Lambosaurus/KicadLib/README.md

Kicad Libraries

# Installation
1. Open the dialog `Preferences -> Add Paths`
2. Add the key `LAMBO_LIB` with the library path, ie: `C:\dev\Kicad`
3. Import symbols using `Preferences -> Manage symbol libraries`
    - It is reccommended to add `sym-lib-table` as a Table library.
4. Import footprints using `Preferences -> Manage footprint libraries`
    - It is reccommended to add `fp-lib-table` as a Table library.
