Lambosaurus/KicadLib/(list of files, cad)

Other CAD files:
Step/module/myc-yt113x-v10_asm-0510.stp
Step/ant/AE_2450AT18A0100001E.step
Step/assembly/RAK3172.stp
Step/batt/Keystone-1043.step
Step/bga/BGA16_P0.35mm.step
Step/cap/CAP1210.step
Step/conn/amass/XT30PW(2+2).STEP
Step/conn/card/KP13B-SF-PEJ.step
Step/conn/dsub/DSUBB62-RA-F.step
Step/conn/hirose/DF40HC-40DS.stp
Step/conn/idc/IDC-Socket_2x25_P2.54mm_Horizontal.step
Step/conn/jst/JST_XH_S9B-XH-A_1x09_P2.50mm_Horizontal.step
Step/conn/push-in/MillMax_9401-0-15-15-23-27-10-0.STEP
Step/conn/rectangular/PIN_SMD_1.27_2x16.step
Step/conn/rj45/RJHSE-5080-04.step
Step/conn/SIM8051-6-0-14-00.STEP
Step/conn/usb/UCB_C_USB4145-03-0070-C.stp
Step/dfn/WSON6_3x3_HDC1080DMBR.stp
Step/diode/SOD882.step
Step/fet/PowerDI3333-8.step
Step/flt/balun_2450BM14G0011.stp
Step/fuse/FUSE0805.step
Step/ind/L_12x12mm_H8mm.step
Step/led/DS_SMD1313.step
Step/lga/LGA6_04_1.1x0.7.stp
Step/mech/BusBar_22x2.5mm.step
Step/mic/IM70D122V01XTMA1.stp
Step/module/Wio-SX1262.step
Step/msop/VSSOP10_05_3x3.step
Step/ntc/NTC0402.step
Step/pem/PEM_M2_4mm.step
Step/pqfn/PQFN8_5x6.step
Step/qfn/QFN40_05_6x6.stp
Step/qfp/LQFP-44_10x10mm_P0.8mm.step
Step/relay/SPDT_ALQ_FormC.step
Step/res/RES_Shunt_0612.step
Step/sensor/BME280.step
Step/so/SOP-4-6.5.step
Step/soic/SOIC-14_3.9x8.7mm_P1.27mm.step
Step/sot/SOT-553.step
Step/sot23/SOT23-8.step
Step/switch/ALPS_SPVS320200.step
Step/switch/limit/SW_XKB_DM1-16UP-1.step
Step/testpoint/5002.STEP
Step/to/TOLL-8.step
Step/transducer/Murata_PKMCS0909E4000-R1.step
Step/transformer/S024-12.2x17.6.STEP
Step/tssop/TSSOP-24.stp
Step/xtal/RV-3028-C7_32.768KHZ_1PPM-TA-QC.step
Step/ant/YC0009AA.stp
Step/assembly/XIAO_ESP32S3_Plus.step
Step/batt/BatteryHolder_Keystone_3034_1x20mm.step
Step/bga/WLCSP-6_1.46x1.1mm_Layout3x2_P0.4mm.step
Step/cap/CAP1206.step
Step/conn/dsub/DSUB09-RA-M.step
Step/conn/flat-flex/F3311A7H121008E200.step
Step/conn/hirose/DF40C-40DP.stp
Step/conn/idc/IDC-Header_2x25_P2.54mm_Vertical.step
Step/conn/jst/JST_XH_S10B-XH-A_1x10_P2.50mm_Horizontal.step
Step/conn/push-in/TBL-0019-350-02BE.step
Step/conn/rectangular/MTA_TH_2.54_1x6.stp
Step/conn/rj45/RJHSE-5381-04.step
Step/dfn/DFN8_5x6_127.step
Step/diode/DIO0603.step
Step/fet/DirectFET_ME.step
Step/fuse/FUSE1206.step
Step/ind/IHLP2525.step
Step/led/WS2812-2020.STEP
Step/lga/LGA-14_2.5x3.step
Step/mech/SMFLP12.0.stp
Step/module/ESP32-S3-WROOM-1U.STEP
Step/msop/VSSOP8_05_2.3x2.step
Step/ntc/NTC0603.step
Step/pem/PEM_M2_2.7mm_Wurth.stp
Step/qfn/QFN6_05_1x1_Skyworks.step
Step/qfp/LQFP-64_10x10mm_P0.5mm.step
Step/relay/AGQ200.step
Step/res/RES1225.STEP
Step/sensor/SHT40-AD1B-R2.STEP
Step/so/SOP-4-4.4.step
Step/soic/SOIC-16_3.9x9.9mm_P1.27mm.step
Step/sot/SOT-543.step
Step/sot23/SOT23-5.step
Step/switch/ESE-24MV1.stp
Step/switch/limit/SW_XKB_DM1-16UD-1.step
Step/testpoint/5000.STEP
Step/to/TO252.step
Step/transducer/InvenSense_ICS-40xxx_3.5x2.65mm.step
Step/transformer/SO16-7.11x12.7.STEP
Step/tssop/TSSOP-38.stp
Step/xtal/Crystal_SMD_2Pin_1.6x1.0mm.STEP
Step/assembly/U-BLOX_MAX-M10S-00B.STEP
Step/bga/WLP-4_0.83x0.83mm_P0.4mm.step
Step/cap/CAP1825.step
Step/conn/CON-SMA-EDGE-S.STEP
Step/conn/dsub/DSUB09-RA-F.step
Step/conn/flat-flex/F3311A7H121004E200.step
Step/conn/idc/IDC-Header_2x25_P2.54mm_Horizontal.step
Step/conn/jst/JST_XH_S6B-XH-A_1x06_P2.50mm_Horizontal.step
Step/conn/rectangular/MTA_TH_2.54_1x5.stp
Step/conn/rj45/RJMG1S8008101BR.stp
Step/conn/usb/USB_C_USB4105-GF-A-060.step
Step/dfn/DFN12_3x3_05.step
Step/diode/DIO0402.step
Step/fet/DirectFET_L8.step
Step/fuse/FUSE0603.step
Step/ind/IHLP2020.step
Step/led/LED1206_RVS.stp
Step/lga/LGA20_2.5X3.step
Step/mech/K3D-MM60-EZH039-B5-R2.STEP
Step/module/EG800Q-EU.step
Step/msop/MSOP8_065_3x3.step
Step/pem/PEM_M2_2mm.step
Step/qfn/QFN48_04_6x6.stp
Step/qfp/LQFP-48_7x7mm_P0.5mm.step
Step/relay/STST_NO_ALFG_FormA.step
Step/res/RES0612.STEP
Step/sensor/VL53L3CXV0DH_1.STEP
Step/soic/SOIC-8_3.9x4.9mm_P1.27mm.step
Step/sot/SOT-883.STEP
Step/sot23/SOT23-3.step
Step/switch/limit/SW_XKB_DM1-12UP-1.step
Step/switch/SW_SPST_SKQG_WithStem.step
Step/testpoint/5001.step
Step/transducer/SMT-0827-S-HT-R.step
Step/tssop/TSSOP-48.stp
Step/xtal/Crystal_SMD_2Pin_2.0x1.2mm.STEP
Step/assembly/XIAO_nRF54L15_Sense.step
Step/cap/CAP2220.step
Step/conn/flat-flex/F3311A7H121030E200.step
Step/conn/idc/IDC-Header_2x05_P2.54mm_Vertical.step
Step/conn/jst/JST_XH_S7B-XH-A_1x07_P2.50mm_Horizontal.step
Step/conn/keystone_1017-1.step
Step/conn/rectangular/MTA_TH_2.54_1x7.stp
Step/conn/rj45/RJHSE-5080.step
Step/conn/usb/USB_B_TH_Vertical.step
Step/dfn/WSON6_1.5x1.5_05.step
Step/diode/SOD523.step
Step/fuse/0678L.step
Step/ind/IND1008.step
Step/led/LED0402.stp
Step/lga/LGA16_3x3_05.step
Step/module/INIR2-ME100.STEP
Step/msop/MSOP16_05_3x4.step
Step/pem/PEM_M3_2mm.step
Step/qfn/QFN16_05_3.5x3.5.step
Step/qfp/LQFP-32_7x7mm_P0.8mm.step
Step/relay/SPDT_JW1_FormC.step
Step/res/RES5931.step
Step/sot/SOT-89-3.step
Step/assembly/ESP32-C6-DEVKITC-1-N8.step
Step/assembly/SeedStudio_L76K.step
Step/cap/CAP0201.step
Step/cap/CAP0402.step
Step/cap/CAP0603.step
Step/cap/CAP0805.step
Step/cap/CAP1808.step
Step/cap/CAP1812.step
Step/cap/CAP2225.step
Step/cap/CP_Elec_10x7.7.step
Step/cap/CP_Elec_16x17.5.step
Step/cap/CP_Elec_18x17.5.step
Step/cap/CP_Elec_3x5.4.step
Step/cap/CP_Elec_4x5.4.step
Step/cap/CP_Elec_5x5.4.step
Step/cap/CP_Elec_6.3x5.9.step
Step/cap/CP_Elec_8x6.9.step
Step/conn/0786463001.step
Step/conn/1042240820.step
Step/conn/1746978.step
Step/conn/A-1JB.step
Step/conn/CUI_DEVICES_SJ-43516-SMT-TR.step
Step/conn/CUI_SJ-3524-SMT-TR.STEP
Step/conn/MEM2075-00-140-01-A.step
Step/conn/card/1775862-2.step
Step/conn/circular/M12-3A-M-Vert.step
Step/conn/circular/M12-4A-M-Vert.step
Step/conn/circular/M12-5A-M-Vert.step
Step/conn/flat-flex/2005280080_0.step
Step/conn/flat-flex/62684-502100ALF.step
Step/conn/flat-flex/F3311A7H121006E200.step
Step/conn/flat-flex/F3311A7H121012E200.step
Step/conn/flat-flex/F3311A7H121020E200.stp
Step/conn/idc/IDC-Header_2x03_P2.54mm_Horizontal.step
Step/conn/idc/IDC-Header_2x03_P2.54mm_Vertical.step
Step/conn/idc/IDC-Header_2x04_P2.54mm_Horizontal.step
Step/conn/idc/IDC-Header_2x04_P2.54mm_Vertical.step
Step/conn/idc/IDC-Header_2x05_P2.54mm_Horizontal.step
Step/conn/idc/IDC-Header_2x06_P2.54mm_Horizontal.step
Step/conn/idc/IDC-Header_2x06_P2.54mm_Vertical.step
Step/conn/idc/IDC-Header_2x08_P2.54mm_Horizontal.step
Step/conn/idc/IDC-Header_2x08_P2.54mm_Vertical.step
Step/conn/idc/IDC-Header_2x10_P2.54mm_Horizontal.step
Step/conn/idc/IDC-Header_2x10_P2.54mm_Vertical.step
Step/conn/jst/B03B-XASK-1.STEP
Step/conn/jst/B2B-PH-SM4-TB.step
Step/conn/jst/B3B-PH-SM4-TB.step
Step/conn/jst/JST_GH_BM02B-GHS-TBT.step
Step/conn/jst/JST_GH_BM03B-GHS-TBT.step
Step/conn/jst/JST_GH_BM04B-GHS-TBT.step
Step/conn/jst/JST_GH_BM05B-GHS-TBT.step
Step/conn/jst/JST_GH_BM06B-GHS-TBT.step
Step/conn/jst/JST_GH_BM07B-GHS-TBT.step
Step/conn/jst/JST_GH_SM02B-GHS-TB.step
Step/conn/jst/JST_GH_SM03B-GHS-TB.step
Step/conn/jst/JST_GH_SM04B-GHS-TB.step
Step/conn/jst/JST_GH_SM05B-GHS-TB.step
Step/conn/jst/JST_GH_SM06B-GHS-TB.step
Step/conn/jst/JST_GH_SM07B-GHS-TB.step
Step/conn/jst/JST_PH_B2B-PH-K_1x02_P2.00mm_Vertical.step
Step/conn/jst/JST_PH_B3B-PH-K_1x03_P2.00mm_Vertical.step
Step/conn/jst/JST_PH_B4B-PH-K_1x04_P2.00mm_Vertical.step
Step/conn/jst/JST_PH_B5B-PH-K_1x05_P2.00mm_Vertical.step
Step/conn/jst/JST_PH_B6B-PH-K_1x06_P2.00mm_Vertical.step
Step/conn/jst/JST_SH_SM04B-SRSS-TB.STEP
Step/conn/jst/JST_XH_B2B-XH-A_1x02_P2.50mm_Vertical.step
Step/conn/jst/JST_XH_B3B-XH-A_1x03_P2.50mm_Vertical.step
Step/conn/jst/JST_XH_B4B-XH-A_1x04_P2.50mm_Vertical.step
Step/conn/jst/JST_XH_B5B-XH-A_1x05_P2.50mm_Vertical.step
Step/conn/jst/JST_XH_B6B-XH-A_1x06_P2.50mm_Vertical.step
Step/conn/jst/JST_XH_S11B-XH-A_1x11_P2.50mm_Horizontal.step
Step/conn/jst/JST_XH_S12B-XH-A_1x12_P2.50mm_Horizontal.step
Step/conn/jst/JST_XH_S13B-XH-A_1x13_P2.50mm_Horizontal.step
Step/conn/jst/JST_XH_S14B-XH-A_1x14_P2.50mm_Horizontal.step
Step/conn/jst/JST_XH_S15B-XH-A_1x15_P2.50mm_Horizontal.step
Step/conn/jst/JST_XH_S16B-XH-A_1x16_P2.50mm_Horizontal.step
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
