Lambosaurus/KicadLib/Step/standard-dimensions.md

# Standard dimensions
Generation parameters for standard chip components.
These can be plugged straight into the Fusion models to re-generate components.

Units in mm.

## Ceramics

For capacitors, ferrites and inductors

| Code | Length | Width | Height | Cap  | Band | Band-Gap |
| ---- | --- | ----- | --- | ---- | ---- | --- |
| 0201 | 0.6 | 0.3 | 0.3 | 0.15 | ? | ? |
| 0402 | 1.0 | 0.5 | 0.5 | 0.2  | ? | ? |
| 0603 | 1.6 | 0.8 | 0.8 | 0.35 | ? | ? |
| 0805 | 2.0 | 1.25  | 1.25 | 0.5  | 0.3  | 0.1 |
| 1206 | 3.2 | 1.6 | 1.25 | 0.5  | 0.5  | 0.2 |
| 1210 | 3.2 | 2.5 | 1.25 | 0.5  | 0.5  | 0.2 |
