Lambosaurus/KicadLib/(commit log)

2021-08-14 Initial import with R's and C's
    [CAP0201.step, CAP0402.step, CAP0603.step, CAP0805.step, CAP1206.step, CAP1210.step, CAP1808.step, CAP1812.step]
2021-08-14 Renamed connectors
    [MTA_TH_2.54_1x10.stp, MTA_TH_2.54_1x2.stp, MTA_TH_2.54_1x3.stp, MTA_TH_2.54_1x4.stp, MTA_TH_2.54_1x5.stp, MTA_TH_2.54_1x6.stp, MTA_TH_2.54_1x7.stp, MTA_TH_2.54_1x8.stp]
2021-08-15 Added leds
    Updated caps & added inductors
    [CAP0201.step, CAP0402.step, CAP0603.step, CAP1206.step, CAP1210.step, CAP1808.step, CAP1812.step, CAP1825.step]
2021-08-16 Add MCU's
    [DFN10_05.step, DFN8_065.step, LQFP100_05.STEP, LQFP120_05.STEP, LQFP144_05.STEP, LQFP32_08.STEP, LQFP48_05.STEP, LQFP64_05.STEP]
2021-10-17 Added ReverseLED and Mounting Pad
2021-11-09 Add assembly and MOSFET
2021-12-24 Added basic diode footprints
    [DO-214AA_SMB.step, DO-214AB-SMC.step, DO-214AC_SMA.step, SOD123.step, SOD323.step]
2021-12-24 Add BJT's and tweak diodes
2021-12-24 Added SOT223-3 Fets
    [SOT-223-3.step, SOT-223-5.step]
2021-12-26 Add fuses
    Fix some diodes & fets
    [F_0603.step, F_0805.step, F_1206.step, TO252.step]
2021-12-26 Fixed diode references
    Added new TVS diode
2021-12-27 Migrating symbol libs to kicad 6
2021-12-27 Add new rectifier diode
    [SOT143.step]
2021-12-27 Migrated to new SOT23 within U_IC library
    [SOT143.step, SOT23-3.step, SOT23-3.stp, SOT23-4.step, SOT23-4.stp, SOT23-5.step, SOT23-5.stp, SOT23-6.step]
2021-12-28 Added DRV8837 and friends
    Changed some stp models to kicad
    [DFN10_05.step, DFN8_05.step, DFN8_065.step, QFN12_05.step, QFN12_065.step, QFN16_05.step, QFN16_065.step, QFN16_08.step]
2022-01-23 Fixed symbol pin spacing
2022-01-29 Updated silkscreens
    Added 2 new N channel FETS
    [SOT-563.step, SOT-963.step]
2022-02-06 Added RT6214 Switch-Mode
2022-02-26 Update silkscreen line widths to 0.15mm
2022-04-16 Added some components. Added electrolytics
    [CP_Elec_10x7.7.step, CP_Elec_16x17.5.step, CP_Elec_18x17.5.step, CP_Elec_3x5.4.step, CP_Elec_4x5.4.step, CP_Elec_5x5.4.step, CP_Elec_6.3x5.9.step, CP_Elec_8x6.9.step]
2022-04-17 Added fuse
2022-04-24 Added new parts
    - 8MHz xtal
    - MCP2551-I/SN CAN transciever
    - LTV-355T Optoisolator
    - Fixed some STM MCU pinouts
    - USBLC6-4SC6 Protection IC
    - M3 Mounting holes
    - USB-BH-2-TH
    - D5V0L2B3SO-7 TVS diode
    - Fixed some Non parts being in BOM
    [Crystal_SMD_Abracon_ABM8G-4Pin_3.2x2.5mm.step, SO-4_4.4x3.6mm_P2.54mm.step, USB_B_TH_Horizontal_CUI.step]
2022-06-11 Add new parts
    [USB_Mini_B_Horizontal.step]
2022-06-11 Increase SOT23-6 footprint size
2022-08-27 - Add MP3612 - Add STM32G061 & QFN28 footprints - Tweak pin 1 indicators on QFNs - Add SC70 footprints
    [DFN8_2x2_05.step, DFN8_3x3_065.step, QFN28_05_4x4.step, SOT-323_SC-70-3.step, SOT-343_SC-70-4.step, SOT-353_SC-70-5.step, SOT-363_SC-70-6.step]
2022-09-17 Added some 2.54mm pins
2022-09-17 Add some new parts
    [Crystal_SMD_3225-4Pin_3.2x2.5mm.step, Crystal_SMD_4Pin_2.0x1.6mm.step, Crystal_SMD_Abracon_ABM8G-4Pin_3.2x2.5mm.step]
2022-11-09 New components
    Updated diode silk screens
    D_Diode: RB751S40T1G, TZMB4V3-GS08
    X_Oscillators: SC32S-7PF20PPM
    U_IC: STM32L011FxPx
    F_Fuse: 0686F0500-01, 0ZCF0250FF2C
    Q_BJT: MMBT3906-7-F
    Q_MOSFET: 2N7002-7-F, DMP2004K-7, DMP3028LFDE-13
    S_Switch: B3U-1100P, TL3365AF180QG
    L_Inductor: FB_0402
    J_Connector: generic 2.54 pins
    [Crystal_SMD_2Pin_3.2x1.5mm.step, Crystal_SMD_4Pin_3.2x2.5mm.step, DFN6_2x2_065.step, D_MiniMELF.step, F_2920.step, SOD523.step, SOD923.step, SW_SPST_B3U-1000P.step]
2022-11-17 Move pads to N_NonPart
    Tweak pin 1 indicators on many IC's
2022-11-22 Add vert USB mini connector Add USBLC protection diode Add FT230XQ IC
    [USB_B_TH_Vertical.step]
2022-11-22 Add TC2050 and EC10 connectors
2023-02-05 Add 12V Charge Pump, and FET Gate Driver
2023-02-06 Fix footprint paths with '.' prefix.
2023-02-06 Component additions
    - SF-0603S050-2 500mA fuse
    - 7499111121A & 7499210121A Ethernet jacks
    - W5500 ethernet controller
    - MAX9938HEUK+T current shunt sensor
    - ECS-250-10-37B-CTN-TR 25MHz xtal
    [7499210121A.stp]
2023-02-06 Fix pinouts on the UART TC2050
2023-02-17 Add components
    * U_MCU ATMEGA8
    * U_Driver: IR2101S
    * Y_Osc: CSTNE16M0V530000R0
    [Oscillator_SMD_3Pin_3.2x1.3mm.step]
2023-03-04 Add 2EDL8024GXUMA1 driver
    [DFN8_4x4_08.step]
2023-03-04 Add IRF7769L1TRPBF
    [DirectFET_L8.step]
2023-03-05 Implement M6 PCB fingers
2023-03-18 Updated many libraries for kicad 7 format
    Fixed SMD/TH attribute on many parts
2023-05-08 Add new components
    TT3301xx switches
    LTSTC19HE1WT LED's
    CR2032 coin cell holder
    [BatteryHolder_Keystone_3034_1x20mm.step, LTST-C19HE1WT.STEP, SW_SPST_PTS645.step]
2023-05-27 Fix footprint for TL3301xx
2023-07-04 Add RM100772BCB rotary switch
    [RM100772BCB.stp]
2023-07-04 Add keystone_240 and other connectors
    [USB_C_USB4105-GF-A-060.step, keystone-PN240.STEP]
2023-08-01 Implement STM32C0 Series + Update PCB Fingers
2023-08-01 Add Additional PCB Finger Sizes
2023-08-02 Updated models for 0805s
    [CAP0805.step, IND0805.step]
2023-08-02 Add some new parts.
    [DFN10_3x3_05.step]
2023-08-02 Add FT2232HQ
    [QFN64_05.step]
2023-09-26 Increase hole sizes on USB-C connector
2023-09-26 Add components
    * ASPI inductors
    * AP3012KTR-G1 boost converter
    * MCP73832T-2ACI/OT charger
    * RP604K331A buck-boost converter
    * FIxed USBLC6 part number
    * AP22804AW5-7 load switch
    * W25X20CLUXIG SPI flash memory
    * BC805M module
    * Added STM32L052 variant
    * Fixed some pin types on other MCU's
    [ASPI-4030S.STEP, BC805M.step, DFN12_2.7x3_05.step, SON8_2x3_05.step]
2023-10-03 Fix some pins and visible footprint labels
    update footprint for coin cell holder
2023-10-03 Add PCF85063ATL RTC
    [DFN10_2.6x2.6_05.STEP]
2023-10-17 Update errors in Buck Footprint Pinout
2023-10-17 Add various components
    * MP9486GN-Z
    * MYC-Y113X
    * ASPI-6045S inductors
    * DMC2400UV-7 dual fet
    [ASPI-6045S.step, myc-yt113x-v10_asm-0510.stp]
2023-10-17 Added 10K NTC
    Also version update for Res & Diode libs
2023-10-17 Add some connectors
    * MEM2075-00-140-01-A uSD card holder
    * F3311A7H121006E200 FPC connector
    * B2B-PH-SM4-TB JST connector
    * 62684-502100ALF FPC connector
    [62684-502100ALF.step, B2B-PH-SM4-TB.step, F3311A7H121006E200.step, MEM2075-00-140-01-A.step]
2023-10-17 Update for USB connectors
    Add 10118193-0001LF USB connector
    Change pin naming convention for shield pins to "S".
    This should be kept for all connectors.
    [10118193-0001LF.step]
2023-10-19 Fix some broken parts
    Add SJ-3524-SMT-TR 3.5mm connector
    [CUI_SJ-3524-SMT-TR.STEP]
2023-10-19 Remove internal components from YT113 model
    [myc-yt113x-v10_asm-0510.stp]
2023-10-19 Hide some non-hidden footprint names
2023-10-19 Add 1206 resistor arrays
    [RES_Array_1206.step]
2023-10-20 Remove default mask sized on many connectors
2023-10-21 Update step models for inductors and caps
    [CAP1206.step, CAP1210.step, CAP1812.step, CAP1825.step, CAP2220.step, CAP2225.step, FB0201.step, FB0402.step]
2023-10-21 Recolor res arrays to 16,16,16 for consistency
    [RES_Array_1206.step]
2023-10-31 Add components
    Add 12Mhz oscillator. (Triggered library update).
    Add 93LC56BT-I/OT memory
    Add 7447709220 inductor
    Add BAT54x diodes
    Add TPS55340 boost converter
    Add 2mm mousebites
    Fuse library update
    [L_12x12mm_H8mm.step]
2023-11-01 Add my fav LEDs as symbols
2023-12-13 Add 1-1825910-4 buttons
    [Tact Swtich TH 6x6x9.5mm.stp]
2024-02-11 Set default value for generic components
    Color LTST LED symbol.
    Create generic diode symbols
    [CUI_DEVICES_SJ-43516-SMT-TR.step]
2024-02-12 BG95M4LA model
    [BG95M4LA-64-SGNS.step]
2024-02-12 rejig BG95 schematics
2024-02-12 add footprint
2024-02-15 Change pin types for BG95
    Also add 2.54 pins x1
2024-02-17 Added components:
    - DMN2011UFDE-7
    - BQ29700DSER
    [WSON6_1.5x1.5_05.step]
2024-02-18 Add 0786463001
    [0786463001.step]
2024-02-19 Add PRG18BB221MB1RB
    Also add generic fuses
2024-02-20 Add MIC2253 boost converter
    [DFN12_3x3_05.step]
2024-02-25 Add JS203011JCQN
    [JS203011JCQN.step]
2024-02-26 Add 1812 fuse model
    [F_1812.step]
2024-02-26 Fuse 1812 + 0ZCG0030FF2C
2024-02-26 Simplify F_1812 step model
    [F_1812.step]
2024-02-26 Add 3V3 TVS diode
2024-02-27 Rearranging connector step files.
    This is a breaking change, and will require affected parts to be updated from the library.
    [62684-502100ALF.step, CUI_DEVICES_TB002-500-02BE.step, CUI_DEVICES_TB002-500-08BE.step, F3311A7H121006E200.step, IDC-Header_2x03_P2.54mm_Horizontal.step, IDC-Header_2x03_P2.54mm_Vertical.step, IDC-Header_2x04_P2.54mm_Horizontal.step, IDC-Header_2x04_P2.54mm_Vertical.step]
2024-03-04 Fix pin power types for AP2281
2024-03-07 Add AP62301WU-7 buck converter
2024-03-07 Fixed some unhidden footprint values
2024-03-30 Recolored ferrite beads
    [FB0201.step, FB0402.step, FB0603.step, FB0805.step, FB1206.step, FB1210.step, IND1206.step, IND1210.step]
2024-03-30 Breaking change: Separated models for fuses and polyfuses
    Added new fuses
    [FUSE0603.step, FUSE0805.step, FUSE1206.step, POLY0603.step, POLY0805.step, POLY1206.step, POLY1812.step, POLY2920.step]
2024-03-30 Rename 4030/6045 footprints
    This is a more generic footprint
    [4030S.step, 6045S.step]
2024-04-01 Update step models for inductors
    [4030S.step, 6045S.step]
2024-04-09 Add DRV8244 + Generic Regulators, NTC & Diode Footprint
    [VQFN-HR-16_3x6.stp]
2024-04-17 Add M2, M3, + M4 PEM
    [PEM_M2_2mm.step, PEM_M3_2mm.step, PEM_M4_2mm.step]
2024-04-17 Fix FS2A Footprint Link
2024-04-17 Add AP64500 Buck Regulator + Inductor
    [L_4.2x4.2x2.step]
2024-06-18 Add AP2205 LDO and Additional PCB Finger Size
2024-07-08 Use FB footprints for NTC's
    Better matches these parts ceramic bodies
2024-07-08 Add M5 mounts & 3 pin screw terminal
    [CUI_DEVICES_TB002-500-03BE.step]
2024-07-08 Add sensor and relay libraries
    [Relay_SPDT_Panasonic_JW1_FormC.step]
2024-07-08 Rework dual diode symbols
2024-07-08 Add 0402 LED model
    [LED0402.stp]
2024-07-13 Add JS202011JCQN switch
    [JS202011JCQN.step]
2024-07-24 Add some parts
    - LM66100DCKR Ideal diode
    - ESP32-C3-MINI-1-H4
    - MP28600GTF-33 boost PSU
    Tweak some footprints for consistency
    [ESP32-C3-MINI-1-H4.STEP, JS203011JCQN.step]
2024-07-24 Add Mini PCIe connectors
    -1775862-2
    - mPCIe edge pads
    [1775862-2.step]
2024-07-26 Add some parts
    - ISO6721BDR bus isolator
    - 0678L9300-02 fuses
    - ALFG1PF12 relay
    [0678L.step, IRM-05-x.stp, SPDT_JW1_FormC.step, STST_NO_ALFG_FormA.step]
2024-07-29 Fixed relay footprints being wrong
2024-07-29 Change pin 1 orientation for ALFG relays
2024-07-29 Update step model for 3.2mm tact switch
    [Tact Switch SMD 4.2x3.2mm.stp]
2024-07-30 Minor fixes
    [IRM-05-x.stp]
2024-08-01 Add some LEDs
2024-08-03 Add M2.5 mount
    Fix PCIE card pads
2024-08-03 Add MFF2 sim
    [DFN8_5x6_127.step]
2024-08-03 Use generic mosfet pattern for standard mosfets
2024-08-03 Add parts
    - FXLA108BQX logic translator
    - 24AA01T-I/OT I2C EEPROM
    - 1042240820 nano sim holder
    [1042240820.step, WQFN20_05_2.5x4.5.step]
2024-08-05 Upload SOT23-8 model
    [SOT23-8.step]
2024-08-06 Kicad 8 library migration
2024-08-06 Add 1mm tooling holes
    Move mouse bites to N_NonPart
2024-08-07 Add MM60-EZH039-B5-R850
    Also upgrade M_Mechanical lib
    [K3D-MM60-EZH039-B5-R2.STEP]
2024-08-10 Fix hole sizes for MM60-EZH039
    Add a default .gitignore for projects
2024-09-11 Delete .dcm files
    These must be an artifact from older KiCad versions
2024-09-24 Support footprints without library prefix
2024-10-04 Add some diodes
    * Added 1N4007FL
    * Added SK220A
    * Tweaked footprint for USBC connector to increase clearance
2024-10-04 Add DIP switches
    [DS04-254-2-01BK-SMT.step, DS04-254-2-02BK-SMT.step, DS04-254-2-04BK-SMT.step, DS04-254-2-06BK-SMT.step, DS04-254-2-08BK-SMT.step]
2024-10-04 Add more components
    * SS24FL diode
    * W25Q80DVUXIE QSPI Flash
2024-10-08 Add connectors
    * 1775862-2 u.fl connector
    * CON-SMA-EDGE-S SMA connector
    * RJHSE508004 4 x rj45 connector
    [CON-SMA-EDGE-S.STEP, RJHSE-5080-04.stp]
2024-10-08 Move test points to TP library
    * Added 5001 test point
    [5001.step]
2024-10-08 Added connectors
    Changed footprint for 3034TR
    Added TB002-500-04BE screw terminals
    [CUI_DEVICES_TB002-500-04BE.step]
2024-10-08 Add TB002-500-05BE
    And some other step models for the future
    [CUI_DEVICES_TB002-500-05BE.step, CUI_DEVICES_TB002-500-06BE.step, CUI_DEVICES_TB002-500-10BE.step, CUI_DEVICES_TB002-500-12BE.step]
2024-10-10 Add Teensy 4.1 Module
2024-10-10 Add Battery Spring Connector
    [keystone_1017-1.step]
2024-10-31 Update footprint for 3034 coin cell
2024-10-31 Add ESP32-D0WD-V3
    [VQFN48-035-ESP32.step]
2024-11-24 Add DRV8870 Motor Driver
2024-12-07 Update Pin Header and LED STEP
    [LED1206_RVS.stp]
2024-12-27 Add some parts
    - M3.5 holes
    - BSS85 FET
    - 0ZCM0002FF2G Fuse
    - BAT54S-7-F Diode array
    - MCP4728T DAC
    - TPS2H160B-Q1 Load switches
    - STM32G0B1CxUx
    - STM32G071CxUx
    [FUSE0603.step, FUSE0805.step, FUSE1206.step, MSOP10_05_3x3.step, MSOP16_05_3x4.step, MSOP8_065_3x3.step]
2024-12-27 Add ADS114S08BIPBSR ADC
    [LQFP32_05.STEP]
2024-12-27 Add CPC1017NTR opto
    This triggered a library update of U_Optos
    [SOP-4.step]
2024-12-27 Add 3020-50-0200-00 25 pin IDC connector
    [IDC-Header_2x25_P2.54mm_Horizontal.step, IDC-Header_2x25_P2.54mm_Vertical.step]
2025-01-10 Add parts
    - TC1262-3.3VDBTR 500mA 3V3 LDO
    - Add VLS6045EX-6R8M inductor
    - TG110-E050N5RL pulse transformer
    - MTJ-88ARX1-FSM-LH RJ45
    [8040S.step, RJHSE5387.step, SO16-7.11x12.7.STEP]
2025-01-20 Add Pin 1 bar to so16
2025-02-12 Add parts
    * F3311A7H121012E200 FFC connector
    * SFH11-PBPC-D25-RA-BK socket
    * TBL-0019-350-02BE push-in connector
    * CM1-1275C-050 buzzer
    * PCA9685BS,118 I2C LED driver
    [CMI-1275C-050.STEP, F3311A7H121012E200.step, IDC-Socket_2x25_P2.54mm_Horizontal.step, SO16-7.11x12.7.STEP, TBL-0019-350-02BE.step]
2025-02-18 Add parts
    CPDUR5V0-HF diode | TPS7B92050DBVR ldo
2025-02-22 Add Larger 7mm Inductor
    [L_7.2x6.6x3.step]
2025-02-23 Update output script for kicad 9.0
2025-02-23 Add some parts
    * SMT-0827-S-HT-R buzzer
    * 24AA02E48T-I/OT memory
    * 1746978 connector
    [1746978.step, SMT-0827-S-HT-R.step]
2025-03-01 Add USB4145-03-0170-C
    [UCB_C_USB4145-03-0070-C.stp]
2025-03-01 Add SMT Solder Jumpers and Larger Solder Pads
2025-03-02 Crop PCB renders
2025-03-08 Add Components for BLDC DESC
    STM32F051, FD6288Q, INA180A
2025-03-09 Add High Current FET and Small Buck
    IRF7480MTRPBF, AP63205WU-7
    [DirectFET_ME.step]
2025-03-17 Fix 0402/0603 Diode Footprints
    [DIO0402.step, DIO0603.step]
2025-03-23 Recommit step models as LFS parts
    [DIO0402.step, DIO0603.step]
2025-04-05 Add 0685T1000-01 fuse. Add 1206 FB tempalte Remove duplicate lines on fuse symbols. Fix casing for 4030S step model Add DMN3016LFDE-13 FET Add INA180A2IDBVR current amp
2025-04-05 Add ICS-40212 microphone
    [InvenSense_ICS-40xxx_3.5x2.65mm.step]
2025-04-07 Fix typo in USB C vert connector
2025-04-08 Fix incorrect DS for STM32G0B1
2025-04-08 Add JST-XH connectors
    [JST_XH_B2B-XH-A_1x02_P2.50mm_Vertical.step, JST_XH_B3B-XH-A_1x03_P2.50mm_Vertical.step, JST_XH_B4B-XH-A_1x04_P2.50mm_Vertical.step, JST_XH_B5B-XH-A_1x05_P2.50mm_Vertical.step, JST_XH_B6B-XH-A_1x06_P2.50mm_Vertical.step]
2025-04-08 Add PowerDI3333 footprint
    [PowerDI3333-8.step]
2025-04-09 Fix footprint for ICS-40212
2025-04-10 Update DS_0606 footprint
    Add bars to improve polarity identification
2025-04-12 Silence output from html-bom
2025-04-15 Added SWRA117D antenna
2025-04-16 Add MP2672A charger
    [QFN18_04_2x3.step]
2025-04-28 Add STM32G070RxTx
    Update the models used for LQFPs
    [LQFP-32_5x5mm_P0.5mm.step, LQFP-32_7x7mm_P0.8mm.step, LQFP-48_7x7mm_P0.5mm.step, LQFP-64_10x10mm_P0.5mm.step, LQFP100_05.STEP, LQFP120_05.STEP, LQFP144_05.STEP, LQFP32_08.STEP]
2025-05-07 Add components
    * VEML3328 I2C color sensor
    * TCA9548ARGER I2C multiplexer
    * AGQ200A03Z relay
    * SMFLP12.0 light pipes
    * RJHSE-5080 RJ45 connector
    * SMAJ30A-13-F TVS diode
    [80216oplga4l.stp, AGQ200.step, RJHSE-5080.step, RJHSE-5387.step, SMFLP12.0.stp]
2025-05-07 Remove footprint filters from USB connectors
2025-06-01 Add ESP32-C3-MINI-1U
    [ESP32-C3-MINI-1U.STEP]
2025-06-01 Add M2.5 PEMs
    [PEM_M2_2.7mm_Wurth.stp]
2025-06-03 Add TPS631000
    [SOT-583-8.step]
2025-06-04 Rename A-1JB footprint to U.FL
2025-06-04 Remove solder mask from BG95
2025-06-04 Add NSIM-16-B Nano SIM
    [SIM8051-6-0-14-00.STEP]
2025-06-12 Add 3920 Current Sense Resistor
2025-06-12 Add STM32F070
    [RES3920.step]
2025-06-12 Add 5x6 PQFN FET
    [PQFN8_5x6.step]
2025-06-16 Add some JST parts
    * B3B-PH-SM4-TB
    * B03B-XASK-1
    [B03B-XASK-1.STEP, B3B-PH-SM4-TB.step]
2025-06-16 Add some parts
    * IFSC1515AHER1R0M01 inductor
    * BQ25303J charger
2025-06-16 Recolor JST step model
    [B03B-XASK-1.STEP]
2025-06-18 Add DS04-254-2-03BK-SMT dip switch
    [DS04-254-2-03BK-SMT.step]
2025-06-19 Expand test hoops to black, white and red
    [5000.STEP, 5002.STEP]
2025-06-19 Add SOD882 TVS 3V3 Diode
    [SOD882.step]
2025-06-19 Add JST PH TH connectors
    [JST_PH_B2B-PH-K_1x02_P2.00mm_Vertical.step, JST_PH_B3B-PH-K_1x03_P2.00mm_Vertical.step, JST_PH_B4B-PH-K_1x04_P2.00mm_Vertical.step, JST_PH_B5B-PH-K_1x05_P2.00mm_Vertical.step, JST_PH_B6B-PH-K_1x06_P2.00mm_Vertical.step]
2025-06-19 Add Core1106 Module
    [Core1106.stp]
2025-06-20 Add Molex PicoBlade Connectors
    [530470210.stp, 530470310.stp, 530470410.stp]
2025-06-20 Add small cheap SOT23 MOSFET
    Nexperia 2N7002,215
2025-06-20 Overhaul pin1 markings on DFN's and QFN's
    [SOT-89-3.step, VSSOP8_05_2.3x2.step]
2025-06-21 Fix some connectors
    * Re-add B03B-ASK-1
    * Fix CT3151V1
2025-06-24 Add RHT Sensor
    TI HDC1080DMBR
    [WSON6_3x3_HDC1080DMBR.stp]
2025-06-25 Fix Core1106 Symbol Pinout
    Move long pin names into alternative function sections of pin definitions
2025-06-25 Add TMC Stepper Driver
    TMC2208-LA-T
2025-06-30 Add SDP810-500Pa pressure sensor
    [SDP810-500PA.stp]
2025-06-30 Add 7mm QR markings for QC
    Update keystone 240 model
2025-07-01 Resolve Footprint Issues
    Core1106 + TMC2208
    [QFN28_05_5x5.step]
2025-07-01 Add More Connectors
    RJ45 w/o LED + 20p Flat Flex
    [F3311A7H121020E200.stp, RJMG1S8008101BR.stp]
2025-07-19 Add WS2812B LED
    Small Addressable RBG LED
    [WS2812-2020.STEP]
2025-08-07 Fix pdf export for kicad 9.0.3
2025-10-23 Add PDFN 5x6 FET
2025-10-23 Add Bi-Directional Current Sense Amp
2025-11-12 Fix some components
    * SN75176 had incorrect value.
    * ALQ relays had incorrect footprint!
    [SPDT_ALQ_FormC.step]
2025-11-12 Start adding phoenix combicon connectors
    [1757242.stp, 1757255.stp, 1757268.stp, 1757284.stp, 1757307.stp, 1757323.stp, 1757349.stp, 1844210.stp]
2025-11-12 Replace BG95 model with simpler one
    [BG95M4LA-64-SGNS.step, EG915.STEP]
2025-11-29 Add sensors
    * BME280
    * LIS2DTW12
    * LIS2MDL
    * SHT40
    * VL53L4CX
    [BME280.step, LGA-12_2x2mm_P0.5mm.step, SHT40-AD1B-R2.STEP, VL53L3CXV0DH_1.STEP]
2025-11-30 Add 30 pin FFC
    [F3311A7H121030E200.step]
2025-11-30 Add JST-S2B connector
    [S2B-PH-K.step]
2025-12-04 Add QFN28 4x4 footprint
2025-12-19 Add Methane Sensor INIR2-ME100
    [INIR2-ME100.STEP, MillMax_9401-0-15-15-23-27-10-0.STEP]
2025-12-19 Add STM32F103CxTx and STM32F030CxTx
2025-12-19 Add LMR16006YDDCR Buck Regulator
2025-12-19 Add ESP32-C6 and M5 Stamp P4 Modules
    [ESP32-C6-DEVKITC-1-N8.step]
2025-12-19 Add 01x09 Pin Header
2025-12-19 Fix STEP file for QFN28_04_4x4 footprint
    [QFN-28-1EP_4x4mm_P0.4mm_EP2.4x2.4mm.step]
2025-12-19 Add alternate LGA16 footprints
    [LGA16_3x3_05.step, LGA16_3x3_05_3x5y.step]
2025-12-27 Remove duplicate model
    [QFN-28-1EP_4x4mm_P0.4mm_EP2.4x2.4mm.step]
2025-12-27 Add F3311A7H121004E200 FFC connector
    Update other F3311 models
    [F3311A7H121004E200.step]
2025-12-27 Fix JST-S2B-PH-K-S link
    Nitpick on PH connector silkscreen
2025-12-27 Minor footprint changes to squash DRCs
2025-12-28 Add FFC4 0.5mm connector
2026-02-06 Update FFC4 connector
2026-02-06 Add some parts
    * SX1276 Lora transciever
    * PE4259 RF switch
    * ECS-TXO-20CSMV-320-EY TCXO
2026-02-18 Add parts
    * ECS-2520MVLC-010-BN-TR oscillator
    * ST3232CDR 232 transceiver
    * HI-3585 & HI-3587 ARINC transceivers
    * TPS60403DBVR charge pump
    [LQFP-44_10x10mm_P0.8mm.step, Oscillator_SMD_4Pin_2.5x2.0mm.step, SOIC-16_3.9x9.9mm_P1.27mm.step]
2026-02-18 Add EG800Q modem
    [EG800Q-EU.step]
2026-02-19 Add ESP32-C6-MINI
    Update to newer HOLT IC's
2026-03-01 Add parts
    Add L77HDC62SD1CH4F DB62 connector
    Add INA226AQDGSRQ1 monitor
    Add TPS16413 power switch
    [DB62-RA-F.step, VSSOP10_05_3x3.step]
2026-03-18 Add CT options
    * PT61018PEL
    * PT61020EL
    [S024-12.2x17.6.STEP, SO16-7.11x12.7.STEP]
2026-03-19 Add 1.27mm pins
    [PIN_SMD_1.27_2x16.step]
2026-03-21 Fix SO24 footprint
2026-03-24 Create Motor Library
2026-03-24 Move NTC From R to RT Thermistor Library
    [NTC0402.step, NTC0603.step]
2026-03-24 Split Power Library into Linear and Switching
2026-03-26 Add Generic XTAL Symbols and More Footprints
    [Crystal_SMD_2Pin_1.6x1.0mm.STEP, Crystal_SMD_2Pin_2.0x1.2mm.STEP]
2026-03-26 Move RB161QS-40T18R Diode to Genetic SMD1006 Footprint
2026-03-26 Add More Resistor Options
    0612, 0815, 1218, 1225
    [RES0612.STEP, RES0815.STEP, RES1225.STEP]
2026-03-26 Widen SOT23-3 Pads
    Widen pads to match SOT23-4/SOT23-5 and improve solderability
2026-03-26 Add Another Standard Ceramic Capacitor
    1808
2026-04-21 Add 3-phase gate driver with integrated diodes
    DRV8300DPWR
2026-04-21 Add 02x03 header
    Mating connector for Tag Connect
2026-06-17 Add JST GH Series to Connectors
    [JST_GH_BM02B-GHS-TBT.step, JST_GH_BM03B-GHS-TBT.step, JST_GH_BM04B-GHS-TBT.step, JST_GH_BM05B-GHS-TBT.step, JST_GH_BM06B-GHS-TBT.step, JST_GH_BM07B-GHS-TBT.step, JST_GH_SM02B-GHS-TB.step, JST_GH_SM03B-GHS-TB.step]
2026-06-17 Add LRA/ERM Vibration Motor Driver
    DRV2605LDGSR
2026-06-17 Add Special Symbol for 256k F030
    STM32F030CCTx
2026-06-17 Create New SMT Bus Bar Component
    [BusBar_22x2.5mm.step, IND1008.step]
2026-06-17 Add Footprint for SOD232 High Energy
2026-06-19 Add a 5931 Resistor
    [RES5931.step]
2026-06-19 Add a 3x5 PCB Finger
2026-07-01 Add 1043 battery holder
    [Keystone-1043.step]
2026-07-01 Add some parts which triggers v10 library format
    * BLM31KN121SN1L
    * Phoenix-PT-1984675
    * TVS3301
    * BZT52C12T-7
    * CSD18543Q3A
    * NVTFS5116PL
    * MAX17320
    [1984675.stp]
2026-07-01 Trigger more v10 updates
    - TPS60403DBVR
    - TPS629210
    - FM24V10-GTR
    - TPS22916
    - TPS22810DR
    - RV-3028-C7
    - SKQGADE010
    - DFE322512F-2R2M=P2
    - WS2812E-1313
    [DS_SMD1313.step, RV-3028-C7_32.768KHZ_1PPM-TA-QC.step, SW_SPST_SKQG_WithStem.step, WLP-4_0.83x0.83mm_P0.4mm.step]
2026-07-02 Add more parts
    - BAV99
    - SN74AXC8T245RJWR
    - DRV5032FBDBZR
    - TPS70950DBVR
    [UQFN24_04_1.4x3.65.step]
2026-07-02 Add hirose connectors
    * DF40C(4.0)-40DS-0.4V
    * DF40C-50DP-0.4V(51)
    [DF40C-40DP.stp, DF40HC-40DS.stp]
2026-07-02 Add parts
    * TPS1H100AQPWPRQ1
    * EFM32...
    [QFN68_04.step]
2026-07-02 Fix footprint on SN74AXC8T245RJWR
2026-07-02 Add more parts
    * BQ25798
    * LMR51635YDDCR
    [BQ25798RQMR.step, IHLP2020.step, IHLP2525.step]
2026-07-02 Add LTV-814S
    [SO-4_4.4x3.6mm_P2.54mm.step, SOP-4-4.4.step, SOP-4-6.5.step]
2026-07-06 Fix some parts
    * DF40C-40DP-0.4V(51)
    * Add SWO labels to TC2030's
    * Fix EFM32 pinout
2026-07-07 Add 2020 inductor footprint
2026-07-08 Add ESP32-S3-WROOM-1U-N16R8
    [ESP32-S3-WROOM-1U.STEP]
2026-07-08 Add new ESP32-P4 and associated QFN104 footprint
    [QFN104_035_10x10.stp]
2026-07-08 Fix ESP32 pinout
2026-07-12 Add XT30PW(2+2) Connector
    [XT30PW(2+2).STEP]
2026-07-12 Add Gate Driver DRV8353RSRGZR
    3-Phase Driver + 3 Current Sense Amps + Integrated Buck
2026-07-12 Fix Pin Locations on ESP P4 Symbol
2026-07-12 Add SOT236 USB TVS Diode
    ESD Protection Data + Vbus
2026-07-12 Add Buck Regulator LM5164DDAR
2026-07-13 Rename dv/dv pin
2026-07-13 Add Bosh BHI360 IMU
    [LGA20_2.5X3.step]
2026-07-14 Add some new step models
    [DF40C-40DP.stp, DF40HC-40DS.stp, KP13B-SF-PEJ.step, PEM_M2_4mm.step]
2026-07-14 Add TPS2116DRLR Power Mux
2026-07-14 Add Piezo Driver IC PAM8904EGP
    [QFN12_04_2x2.step]
2026-07-14 Add passive piezo buzzer PKMCS0909E4000
    [Murata_PKMCS0909E4000-R1.step]
2026-07-14 Add Seed Studio L76K GPS Module
    [SeedStudio_L76K.step]
2026-07-14 Add Seed Studio LoRa SX1262 Module
    [Wio-SX1262.step]
2026-07-14 Fix Seed Studio nRF54L15 SMT footprint
2026-07-14 Fix inner pad numbering on LGA20 footprint
2026-07-14 Add magnetic angle sensor MAQ473GQE-AEC1
2026-07-15 Fix some missing footprints and pins
2026-07-16 Add Step Model to SeedStudio nrf54L15 footprint
    [SeeedStudio_nRF54L15_sense.step]
2026-07-20 Add some parts, and minor field updates
    * MCP1711T-18I/OT
    * Phoenix-PT-1984756
    * Phoenix-Eurostyle-0393570016
    [393570008.stp, SW_SPST_SKQG_WithStem.step]
2026-07-21 Update solder bridge symbol to same size as R/C
2026-07-21 Add JST SH SM04B Step
    [JST_SH_SM04B-SRSS-TB.STEP]
2026-07-27 Add MAX17291BANT+T
    [WLCSP-6_1.46x1.1mm_Layout3x2_P0.4mm.step]
2026-07-27 Add EFM32PG28B200F512IM68
    [QFN40_04.step]
2026-07-27 Add SOT883
    [SOT-883.STEP]
2026-07-29 Add PESD1CAN,215
    CAN TVS diode w/ AEC-Q101 rating
2026-07-29 Fix ESP32-P4 to lineup schematic pins on 2.54 grid
2026-07-29 Add Accelerometer ASM330LHBTR
    [LGA-14_2.5x3.step]
2026-08-03 Add LTC3337ACBZ-R7
    [BGA16_P0.35mm.step]
2026-08-05 Add some new diodes
    * SMAJ22A
    * SMAJ30A
    * SMAJ36A
    * SMF5.0A
    * SMF10A
    * SMF15A
    * SMF22A
2026-08-09 Add BQ24650 charger
    [QFN16_05_3.5x3.5.step]
2026-08-15 Add more Samesky terminal blocks
    [Same_Sky_TB0011-350-02BE.step, Same_Sky_TB0011-350-03BE.step, Same_Sky_TB005-762-02BE.step, Same_Sky_TB005-762-03BE.step]
2026-08-16 add nRF54Lxx symbol and associate QFN48 footprint
    [QFN48_04_6x6.stp]
2026-08-22 Use board stackup colours for renders
2026-08-23 Add DSUB09 connectors
    [DSUB09-Female-Horizontal.step, DSUB09-Male-Horizontal.step]
2026-08-26 Add SOIC14
    Change keepout rules on tag connects
    [SOIC-14_3.9x8.7mm_P1.27mm.step]
2026-09-09 Added some parts
    * SOT553
    * SOT543
    * Tweaked WS2812B-2020 footprint
    [LGA6_04_1.1x0.7.stp, SOT-543.step, SOT-553.step]
2026-09-11 Clean up some component footprints
    [DB62-RA-F.step, DSUB09-RA-F.step, DSUB09-RA-M.step, DSUBB62-RA-F.step]
2026-09-11 Darken 12x12mm inductor model
    [L_12x12mm_H8mm.step]
2026-09-11 Update export scripts
    Allow the HTML bom to be found in site packages - which is easier for github workflows
2026-09-16 Add RF-5381 series
    * Change FT4232HA to FT4232HQ
    [RJHSE-5080-04.step, RJHSE-5080-04.stp, RJHSE-5381-04.step, RJHSE-5381.step]
2026-09-21 Add YC0009AA
    [YC0009AA.stp]
2026-09-24 Add variant support
    Use new native `kicad-cli sch bom` exporter
2026-09-25 Add some M12 connectors
    [M12-3A-M-Vert.step, M12-4A-M-Vert.step, M12-5A-M-Vert.step]
2026-09-29 Add JST XH RA connectors
    [JST_XH_S10B-XH-A_1x10_P2.50mm_Horizontal.step, JST_XH_S11B-XH-A_1x11_P2.50mm_Horizontal.step, JST_XH_S12B-XH-A_1x12_P2.50mm_Horizontal.step, JST_XH_S13B-XH-A_1x13_P2.50mm_Horizontal.step, JST_XH_S14B-XH-A_1x14_P2.50mm_Horizontal.step, JST_XH_S15B-XH-A_1x15_P2.50mm_Horizontal.step, JST_XH_S16B-XH-A_1x16_P2.50mm_Horizontal.step, JST_XH_S2B-XH-A_1x02_P2.50mm_Horizontal.step]
2026-09-29 Add ESE-24MV1
    [ESE-24MV1.stp]
2026-09-30 Add SKY13453-385LF
    [QFN6_05_1x1_Skyworks.step]
2026-09-30 Add molex 0395434308
    [Molex - 395434308.STEP]
2026-09-30 Add SPVS320200
    [ALPS_SPVS320200.step]
2026-10-01 Add F3311A7H121008E200
    [F3311A7H121008E200.step]
2026-10-02 Add DM1-12UP-1
    [SW_XKB_DM1-12UP-1.step, SW_XKB_DM1-16UC-1.step, SW_XKB_DM1-16UD-1.step, SW_XKB_DM1-16UP-1.step]
2026-10-03 Add molex 2005280080
    [2005280080_0.step]
2026-10-03 Revert SOT23-3 footprint changes
2026-10-05 Add XIAO ESP32-S3 Assembly and Fix Xiao nrf54L15
    [XIAO_ESP32S3_Plus.step, XIAO_nRF54L15_Sense.step]
2026-10-05 Add TOLL-8 FET and IPT015N10N5
    [TOLL-8.step]
2026-10-05 Add 0612 4-wire shunt resistor
    [RES_Shunt_0612.step]
2026-10-05 Add IMU - LSM6DS3
2026-10-05 Add XIAO ESP32-S3 STEP
2026-10-05 Add BLDC Driver - DRV8353SR
2026-10-05 Fix LDO power pins on ESP32-P4NRWx
2026-10-05 Add small TPS63020DSJR buck-boot and fix LM5164DDAR pins
2026-10-05 Fix EP pad number for QFN104_035_10x10 footprint
2026-10-05 Add QFN40_05_6x6 footprint
    [QFN40_05_6x6.stp]
2026-10-07 Add small TH vibration motor
    [JYZ0610155.step]
2026-10-07 Add u-blox MAX_M10S-00B
    [U-BLOX_MAX-M10S-00B.STEP]
2026-10-07 Add ceramic bluetooth antenna
    [AE_2450AT18A0100001E.step]
2026-10-07 Add MK Microphone Lib
    [IM70D122V01XTMA1.stp]
2026-10-07 Add larger solder pads
2026-10-07 Fix EP pin number on DRV8830
2026-10-07 Move symbol and footprint libraries into their own sub-folders
2026-10-08 Add reference field to u-blox footprint
2026-10-08 Add RAK3172-TE part
    [RAK3172.stp]
2026-10-08 Update 3920 and 5931 resistor symbols derived
2026-10-09 Add TPS22917DBVR Load Switch
2026-10-09 Create Filter library and add SAW filter
    [SAW5_1.4x1.1.step]
2026-11-04 Add more screw terminals
